amama017/Shebl/Model/Tests/Test.txt

Initial
45, 90 all
-------------------------------------------------------------------------
1st move (Front Right) "L2"
up
T1 -> 59.2619
T2 -> 115.2852
move
T1 -> 38.1687
T2 -> 108.3910
down
T1 -> 28.1371
T2 -> 83.591

BR (45, 90) "L1"
BL (45, 90) "L3"
FL (45, 90) "L4"
--------------------------------------------------------------------------
2nd move (Back Right) "L1"
up
T1 -> 59.2619
T2 -> 115.2852
move
T1 -> 76.9712
T2 -> 114.9879
down
T1 -> 58.5034
T2 -> 89.7309

FR (-0.3610, 69.7594, 74.4763) "L2"
BL (0.3610, -52.1938, -13.6914) "L3"
FL (0.3610, 67.9203, 54.4821) "L4"
---------------------------------------------------------------------------
3rd move (Back Left) "L3"
up
T1 -> -20.4276
T2 -> 57.0137
move
T1 -> 2.5268
T2 -> 82.8660
down
T1 -> -5.0658
T2 -> 56.5413

FR (0.3628, 62.2686, 36.5504) "L2"
BR (0.3575, 36.0291, 87.2954) "L1"
FL (-0.3628, -48.6742, 0) "L4"
---------------------------------------------------------------------------
4th move (Front Left) "L4"
up
T1 -> -27.3154
T2 -> 52.7736
move
T1 -> -61.9308
T2 -> 0
down
T1 -> -54.0448
T2 -> 0

FR (-0.0063, 55.8419, 90.3717) "L2"
BR (-0.0062, 70.0119, 70.8638) "L1"
BL (-0.0063, 55.8451, 90.3711) "L3"
