amama017/Shebl/Model/Tests/Test2.txt

Initial
45, 90 all
-------------------------------------------------------------------------
1st move (Front Right) "L2"
up
T1 -> 59.2619
T2 -> 115.2852
move
T1 -> 38.1687
T2 -> 108.3910
down
T1 -> 28.1371
T2 -> 83.591

BR (45, 90) "L1"
BL (45, 90) "L3"
FL (45, 90) "L4"
--------------------------------------------------------------------------
2nd move (Back Right) "L1"
up
T1 -> 59.2619
T2 -> 115.2852
move
T1 -> 76.9712
T2 -> 114.9879
down
T1 -> 58.5034
T2 -> 89.7309

FR (-0.3610, 67.1170, 82.9129) "L2"
BL (0.3610, -13.1596, 47.2739) "L3"
FL (0.3610, 70.0044, 68.9519) "L4"
---------------------------------------------------------------------------
3rd move (Back Left) "L3"
up
T1 -> -4.7798
T2 -> 75.4427
move
T1 -> 16.8672
T2 -> 95.2415
down
T1 -> 9.2479
T2 -> 70.3792

FR (0.3628, 69.4531, 62.4772) "L2"
BR (0.3573, 39.7517, 88.6286) "L1"
FL (-0.3628, 60.2851, 31.5209) "L4"
---------------------------------------------------------------------------
4th move (Front Left) "L4"
up
T1 -> 86.9735
T2 -> 64.8302
move
T1 -> 92.0674
T2 -> 87.9968
down
T1 -> 69.4531
T2 -> 62.4772

FR (-0.0063, 54.4398, 90.5643) "L2"
BR (-0.0062, 68.7936, 79.0770) "L1"
BL (-0.0063, 54.4425, 90.5641) "L3"
