amama017/Shebl/Model/Tests/untitled.jpg

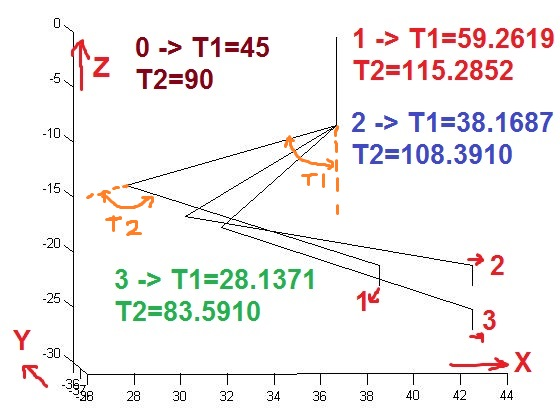
Model/Tests/untitled.jpg
