amama017/Shebl/Power Circuit/Layout.pdf

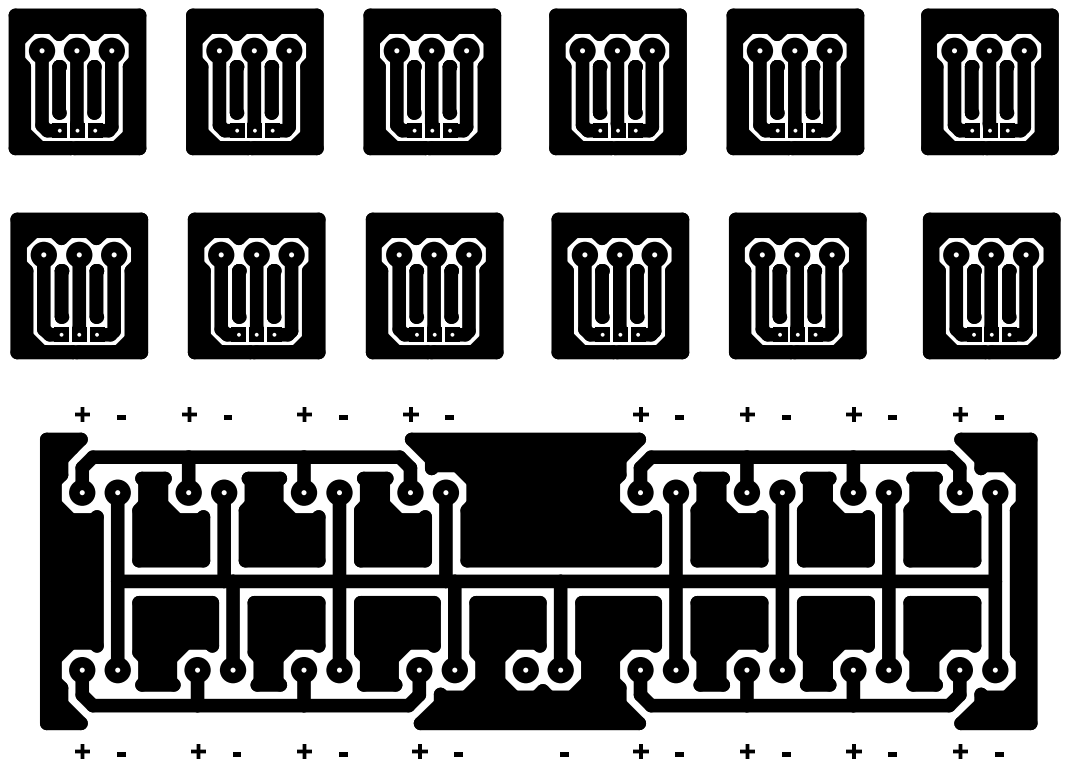
[picture p29: page 1]
