amama017/Shebl/(list of files, drawings)

Other design files:
Power Circuit/Final.LYT
Power Circuit/Motor Connector.DSN
Power Circuit/Motor Connector.LYT
Power Circuit/Power.DSN
Power Circuit/Power.LYT
