amama017/Shebl/(commit log)

2017-09-05 Upload Power Circuit Files
    Add the Schematics and PCB Layout for the power distribution circuit
    [Final.LYT, Motor Connector.DSN, Motor Connector.LYT, Motor Connector.SDF, Power.DSN, Power.LYT, Power.SDF]
2017-09-05 Upload Matlab Model
    Mathematical kinematics & dynamics model for robot motion & stabilization
2017-09-05 Upload Code
    Java & Arduino Code
